tranthamkw/HighVoltageDeflector/BOM_HighVoltageDeflector_2024-04-26.xlsx

Designator | Name |  | Quantity | Cost Each | Extended | Digikey
C1,C2,C3,C4 | 1n |  | 4 |  |  | I will supply this
C5,C6 | 22u |  | 2 | 0.58 | 1.16 | P13532-ND | CAP ALUM 22UF 20% 250V RADIAL
C7,C9 | 100u |  | 2 | 1.21 | 2.42 | 1189-1185-ND | CAP ALUM 100UF 20% 200V RADIAL
D1,D2,D3,D4,D5,D7,D8,D9 | 1N4004 |  | 8 | 0.09 | 0.72 | 2368-1N4004-ND | DIODE GEN PURP 400V 1A DO41 | This item is only sold in bags of 50
D6,D10 | 1N5375BG |  | 2 |  | 0 | 1N5375BGOS-ND | DIODE ZENER 82V 5W AXIAL
J1,J3,J4,J5 | 4-pin PCB Male |  | 4 | 0.35 | 1.4 | WM4202-ND | CONN HEADER VERT 4POS 2.54MM | These items are optional, but recommended. If a board ever fails from, e.g. a short in the electron optics, having connectors will make it easy to replace
 | 4-pin receptical |  | 4 | 0.26 | 1.04 | WM2002-ND | CONN RCPT HSG 4POS 2.54MM
J2 | 6-pin PCB Male |  | 1 | 0.45 | 0.45 | WM4204-ND | CONN HEADER VERT 6POS 2.54MM
 | 6-pin receptical |  | 1 | 0.46 | 0.46 | WM2004-ND | CONN RCPT HSG 6POS 2.54MM
 | connector pin |  | 20 | 0.213 | 4.26 | WM2756-ND | CONN 22-30AWG CRIMP TIN
Q1,Q2,Q3,Q4,Q5,Q12,Q13,Q14,Q15, Q16,Q17,Q18,Q19,Q20,Q21,Q28, Q29,Q30,Q31,Q32 | 2N5401G-B-T92-B |  | 20 | 0.239 | 4.78 | 488-2N5401YTACT-ND | TRANS PNP 150V 0.6A TO92-3
Q6,Q7,Q8,Q9,Q10,Q11, Q22,Q23,Q24,Q25,Q26,Q27 | 2N5550TFR |  | 12 | 0.244 | 2.928 | 2N5550TFRCT-ND | TRANS NPN 140V 0.6A TO92-3
R1,R2,R9,R14,R19,R20 | 2.2k | .25W | 6 | 0.1 | 0.6 | CF14JT2K20CT-ND
R3,R6,R17,R22 | 220R | 1W | 4 | 0.26 | 1.04 | RSF1JT220RCT-ND
R4,R5,R18,R21 | 220k | 1W | 4 | 0.47 | 1.88 | A131513CT-ND
R7,R8,R10,R11,R12,R13,R15,R16 | 100k | .25W | 8 | 0.1 | 0.8 | 13-CFR-25JR-52-100KCT-ND
R23,R24,R25,R26 | 51k | .25W | 4 | 0.1 | 0.4 | 13-MFR-25FTE52-51KCT-ND
R27,R28 | 2.7k | 3W | 2 | 0.44 | 0.88 | A131568CT-ND
NA | Transformer |  | 1 | 17.29 | 17.29 | 237-1624-ND | XFRMR ISOL 115V 230V-115V 50VA
NA | 100k Pot |  | 2 | 24.08 | 48.16 | 3590S-2-104L-ND | POT 100K OHM 2W WIREWOUND LINEAR | These items are the most expensive in the list, accounting for about 50% of the total cost. If you can find another source, or use just a cheaper single turn 100k pot.
 | transistor socket |  | 8 | 0.56 | 4.48 | D01-9970342-ND | CONN SOCKET SIP 3POS GOLD | Otptional, but recommended. If the outputs are ever shorted, the two output transistors for each section are the most likely to die
 |  |  |  |  | 95.148
