tranthamkw/HighVoltageDeflector/ComponentMap&Errata.pdf

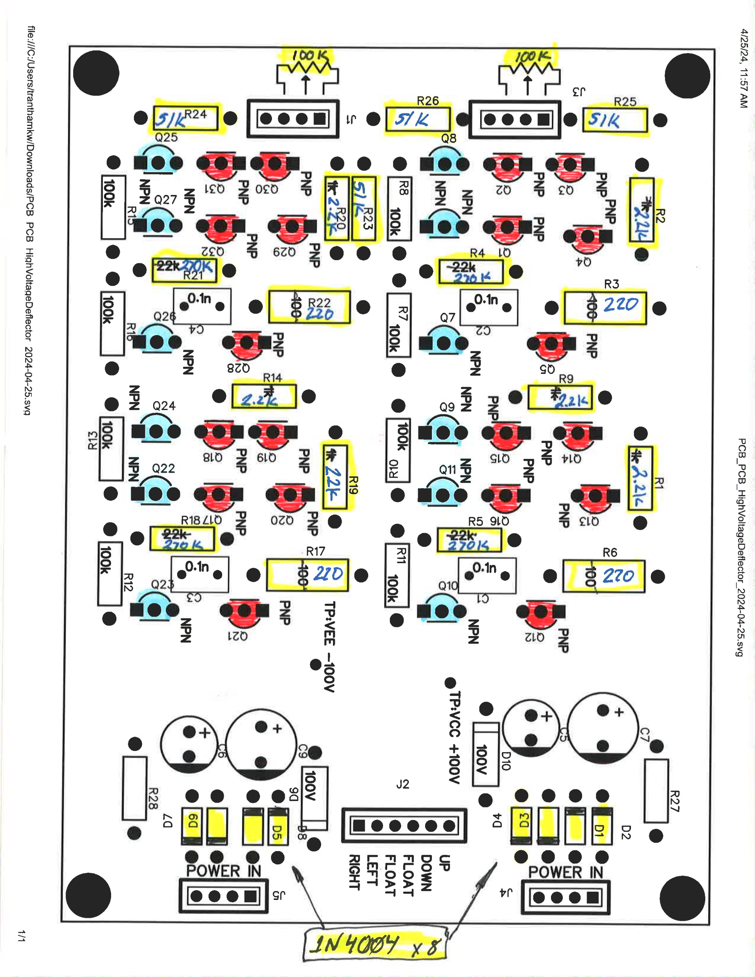
[picture p6: page 1]
