tranthamkw/HighVoltageDeflector/Scheme-it-export-DEFLECTOR-ASSEMBLY-2024-04-30-11-10.pdf

## D/BGR

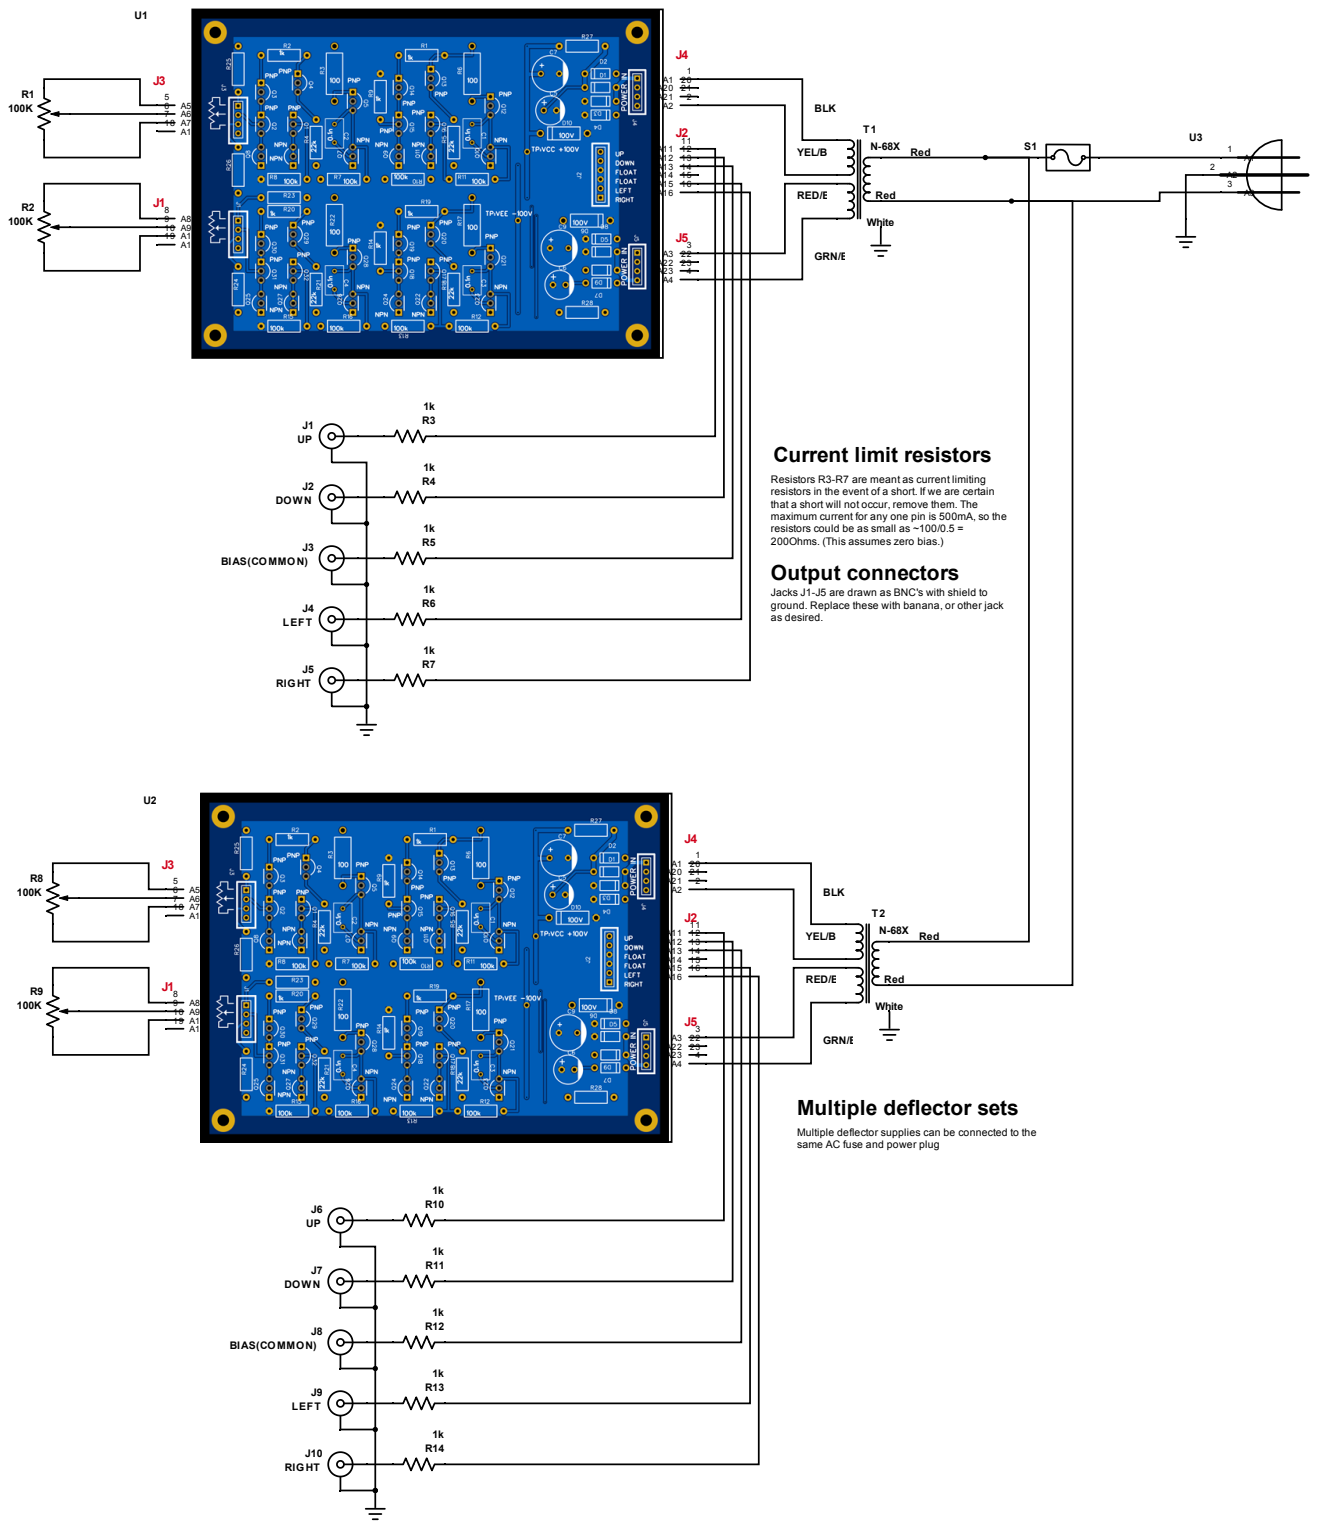
[picture p1: page 1]
hit; t limit; sis; esist; ors; are; nt limitin; Jacks J1-J5; dra; gro; place th; ese; with; a, or oth; er jack; esire; D/BGR; ultiple; fle; flect; plies ca; ect; use; er plu

g resistors in the event of a short. If we are certain that a short will not occur, remove them. The maximum current for any one pin is 500mA, so th

nt as curre

e resistors could be as small as ~100/0.5 = 200Ohms. (This assumes zero bias.) Output connectors

with shield to
