tranthamkw/HighVoltageDeflector/Schematic_HighVoltageDeflector_2024-03-05.pdf

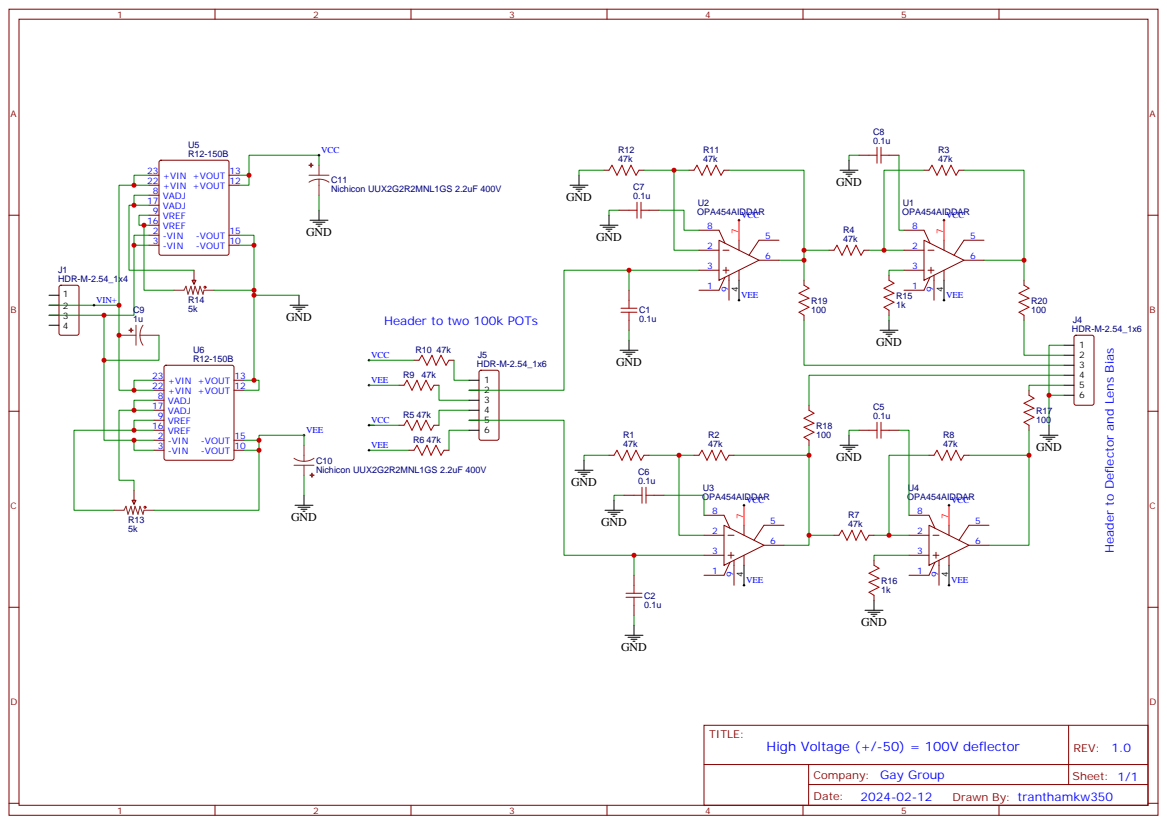
[picture p2: page 1]

Header to two 100k POTs

Header to Deflector and Lens Bias
