tranthamkw/HighVoltageDeflector/Schematic_HighVoltageDeflector_2024-04-26.pdf

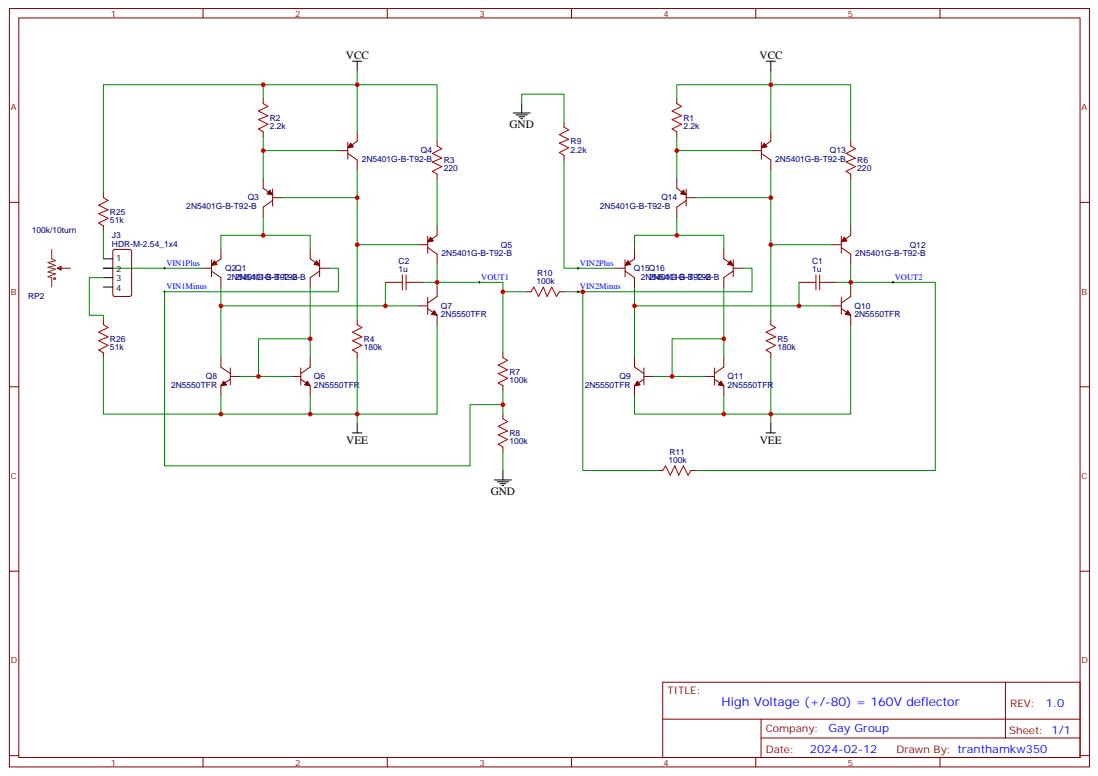
[picture p3: page 1]

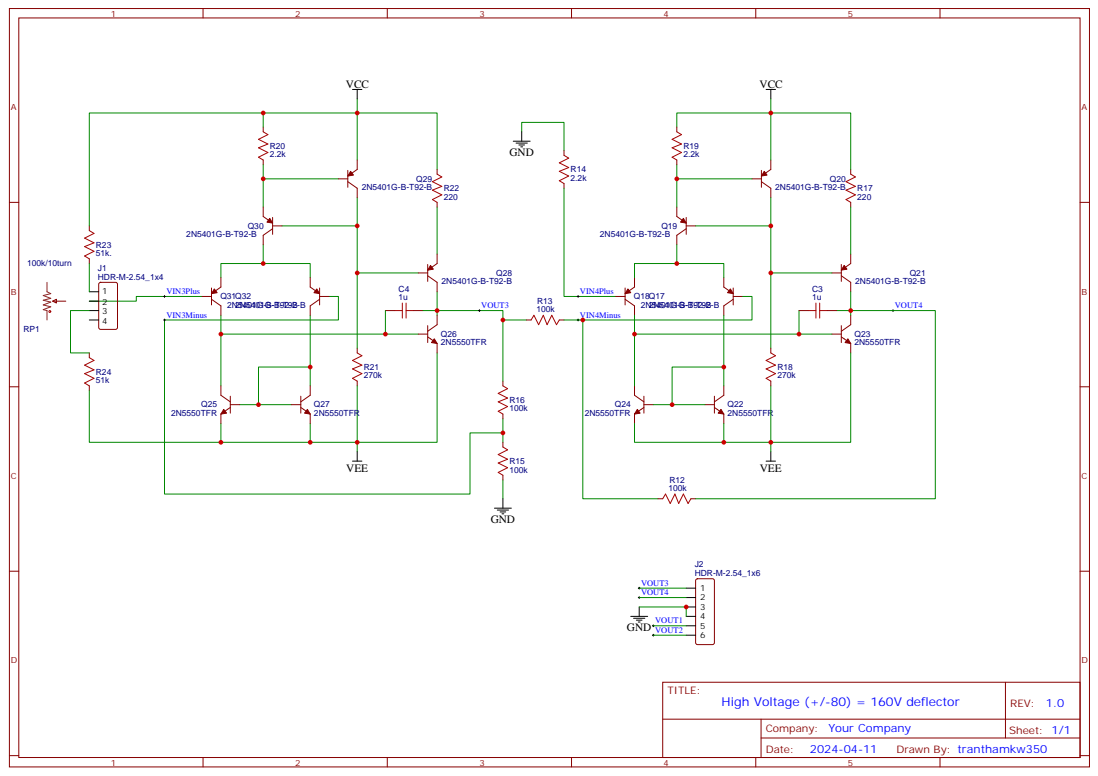
[picture p4: page 2]

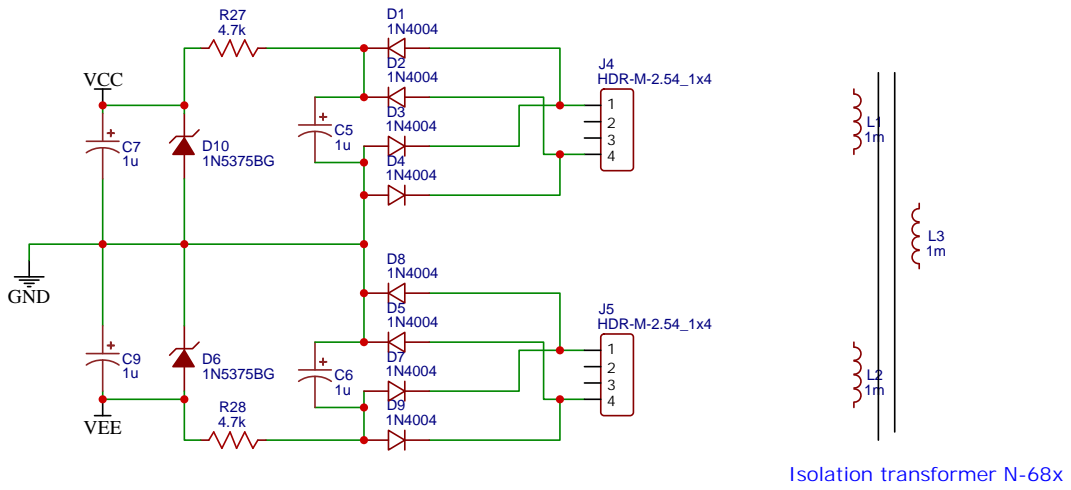
[picture p5: page 3]
