tranthamkw/HighVoltageDeflector/BJTopamp.asc

C1: cap; 100p
C2: cap; 100p
Q1: npn; 2N5550
Q2: npn; 2N5550
Q3: npn; 2N5550
Q4: pnp; 2N5401
Q5: pnp; 2N5401
Q6: pnp; 2N5401
Q7: pnp; 2N5401
Q8: pnp; 2N5401
Q9: npn; 2N5550
Q10: npn; 2N5550
Q11: npn; 2N5550
Q12: pnp; 2N5401
Q13: pnp; 2N5401
Q14: pnp; 2N5401
Q15: pnp; 2N5401
Q16: pnp; 2N5401
R1: res; 200
R2: res; 1.8k
R3: res; 22k
R4: res; 100k
R5: res; 100k
R7: res; 100
R8: res; 100k
R9: res; 1k
R10: res; 1k
R11: res; 22k
R12: res; 100k
V1: voltage; 100
V2: voltage; 100
V3: voltage; SINE(0 50 100)
Named nets: 0, VOUT2, in-2, in+2, VOUT1, in-1, in+1, PowerPlus, PowerMinus
.tran .05
Power -
Power +
2N5550TFRCT-ND
2N5550TFR
488-2N5401YTACT-ND
2N5401YTA
Power -
Power +
2N5550TFRCT-ND
2N5550TFR
488-2N5401YTACT-ND
2N5401YTA
